xiang-wang-US/Cycloidal_Turret/Hardware/cycloidal_drive_12_1/12-1 Cycloidal Drive Assembly.STEP

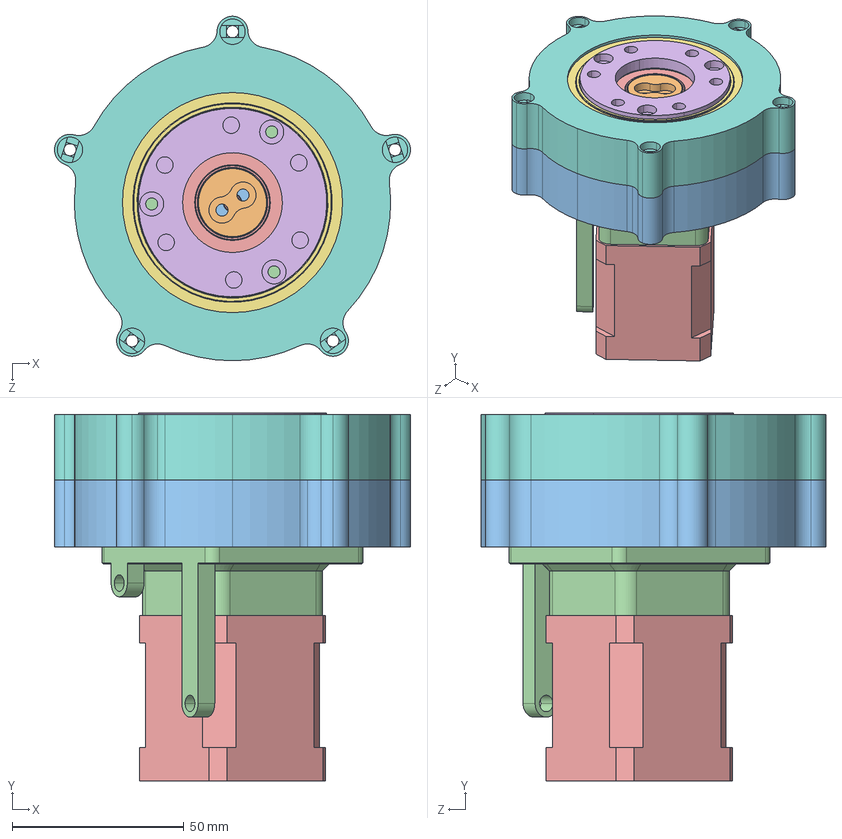
[picture p19: CAD file, 2026-10-12]
Hardware/cycloidal_drive_12_1/12-1 Cycloidal Drive Assembly.STEP
103.5 x 106.9 x 100.2 mm
Rotor Shaft
Rotor B
Rotor A
20x32x7 Bearing Ball x 4
Output B
55x72x9mm Bearing Ball
Housing B
Output A
M5x35 Dowel Pins x 3
Housing A
Nema17 Motor Adapter
42-48 Nema17 Stepper Motor
