xiang-wang-US/Cycloidal_Turret/Hardware/cycloidal_drive_18_1/18-1 Cycloidal Drive Assembly.STEP

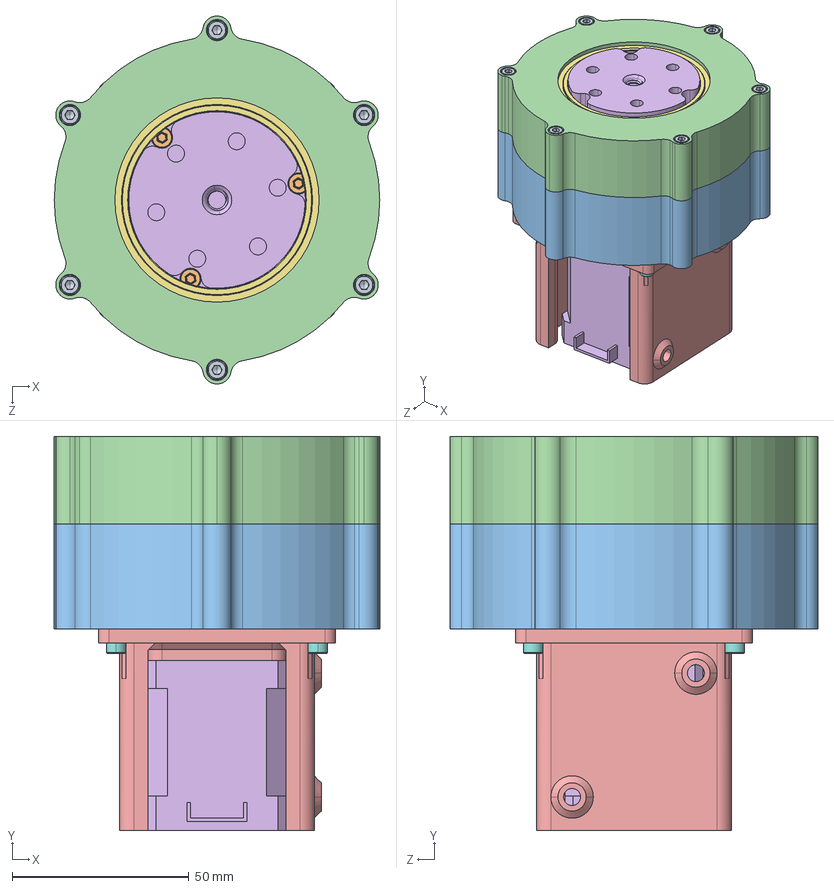
[picture p20: CAD file, 2026-10-12]
Hardware/cycloidal_drive_18_1/18-1 Cycloidal Drive Assembly.STEP
92.0 x 111.4 x 104.0 mm
Rotor Shaft Var1
20x32x7 Bearing Ball x 4
Output B Var1
50x65x7mm Ball Bearing x 2
Output A Var1
M5x30 Dowel Pin x 3
M3x25 Bolt [Simple] x 5
Housing A Var1
Housing B Var1
Nema17 Motor Adapter Var1
42-48 Nema17 Stepper Motor
Rotor B Var1
Rotor A Var1
socket head cap screw_am_B18.3.1M - 3 x 0.5 x 8 Hex SHCS -- 8NHX x 8
socket head cap screw_am_B18.3.1M - 3 x 0.5 x 25 Hex SHCS -- 18NHX x 6
