xiang-wang-US/Cycloidal_Turret/docs/Turret_Design_Journal.pdf

# Turret Main Doc

## Summer 2025

# Brainstorming

## - 2 axis - Gas or Spring for foam darts - Motors? Steppers or BLDC - Controls? ESP32 or Raspberry Pi

- Does base motor spin the top or itself.
- Gas, Stepper, ESP32, coupled.
- Gas and stepper because cheap and easy.
- ESP 32 because cheap.

## - Itself because we wanted 360 without wire tangling

# First Prototype

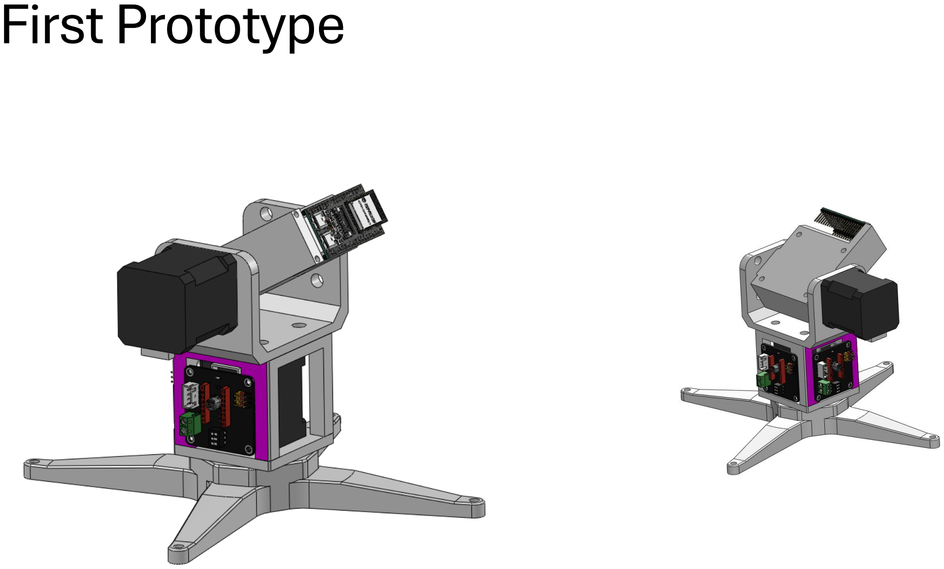
[picture p21: page 3]

Spins freely.

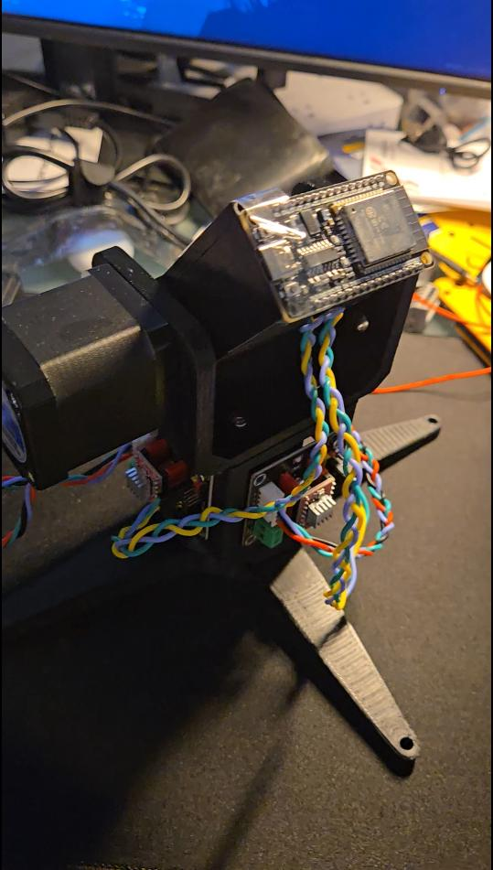
[picture p22: figure]

But the whole top part was very heavily and the motor could not move it.

# Issues

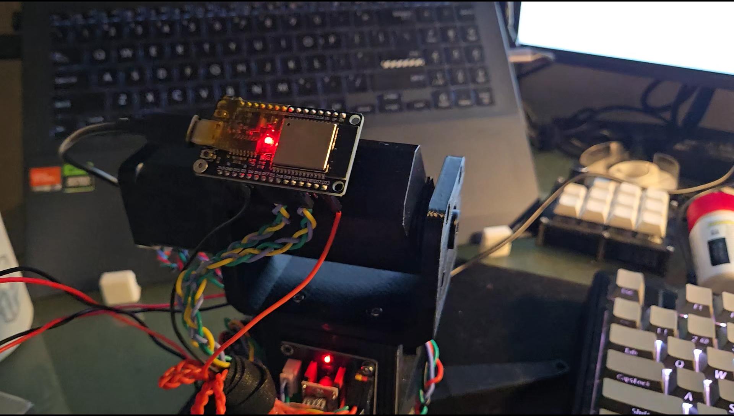
[picture p23: figure]

But the whole top part
was very heavily and
the bottom motor
could not move it.

# Use cycloidal gear reduction?

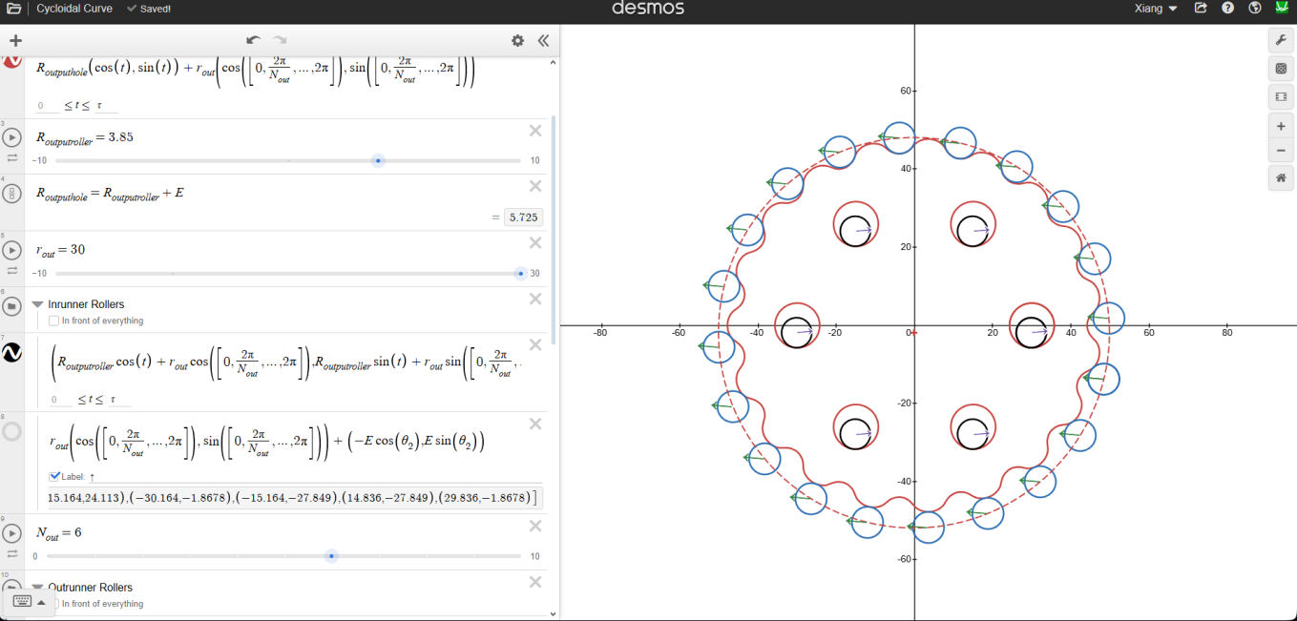
[picture p24: figure]

https://www.desmos.com/calculator/neoglqbxig

Benefits
- Quiet
- Very compact

# Curve in SolidWorks

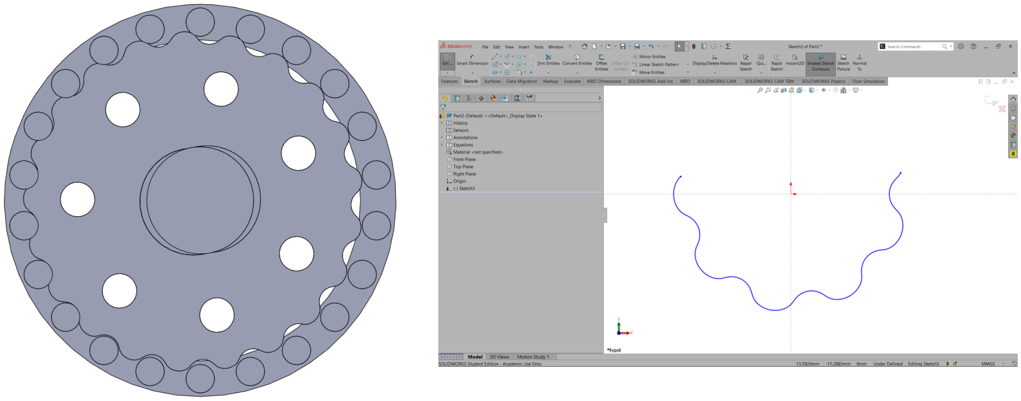
[picture p25: figure]

# Stepper with reducer

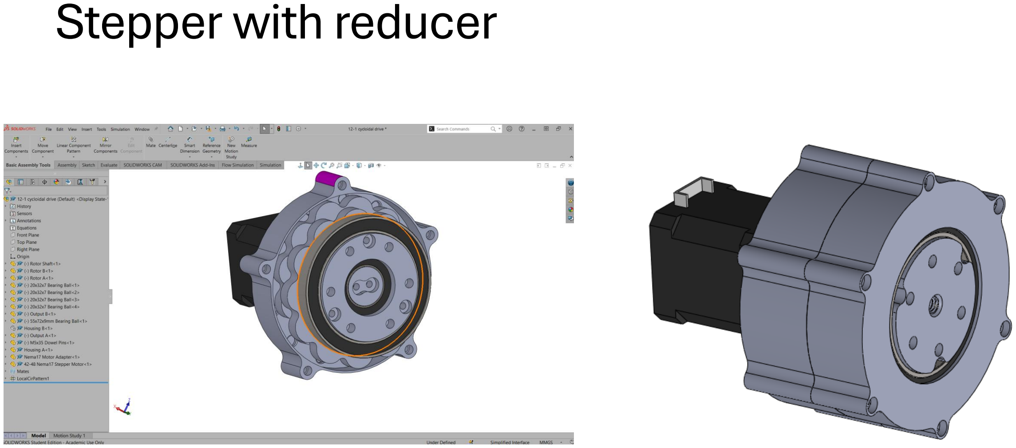
[picture p26: page 8]

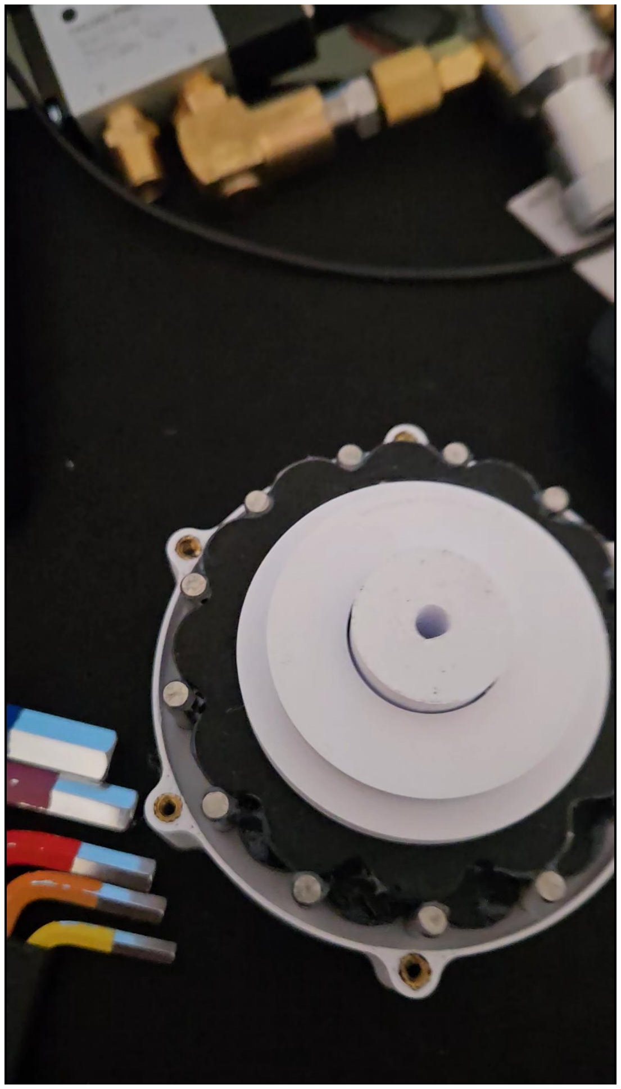
[picture p27: figure]

# Real life validation

# Two perpendiculars sets?

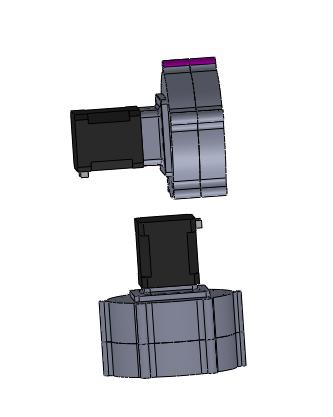
[picture p28: figure]

# Design all the mating brackets

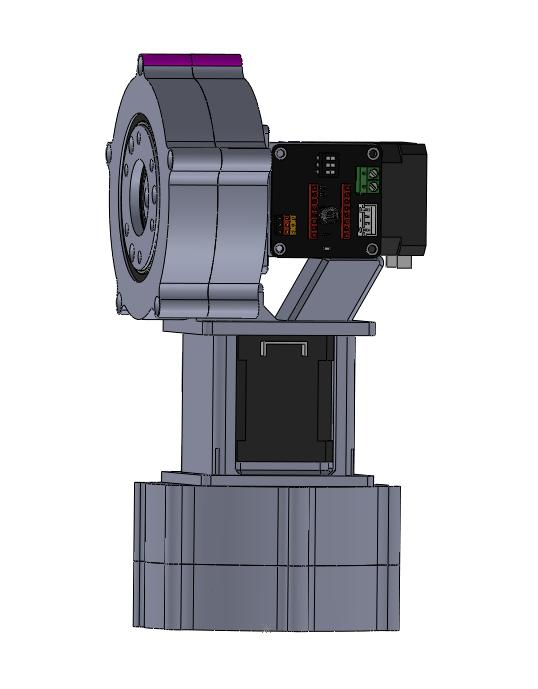
[picture p29: figure]

# Designing gas system

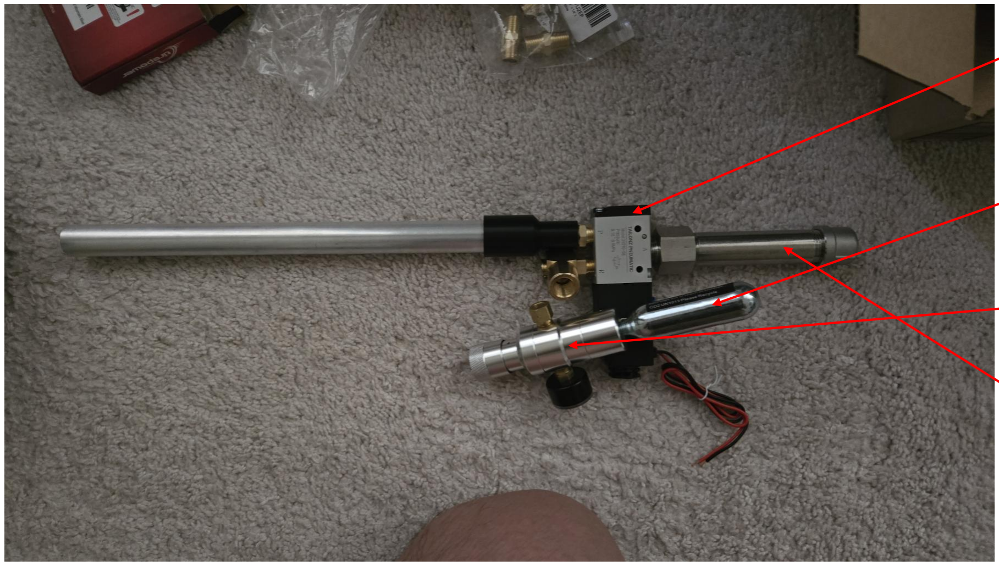
[picture p30: figure]

3 way solenoid
valve

CO2
cartridge

Regulator

Pressure chamber
for cycling shots

# Issue

- Solenoid is not cycling with 12 volts.

## - Increasing voltage does nothing - You can hear it click - People on Amazon say its broken

- Manually cycling it works only along one set of valves.
- Oh you need the increase the pressure going to unstick the valve. It doesn’t work below 20 psi.

# Figuring out why the solenoid didn’t work

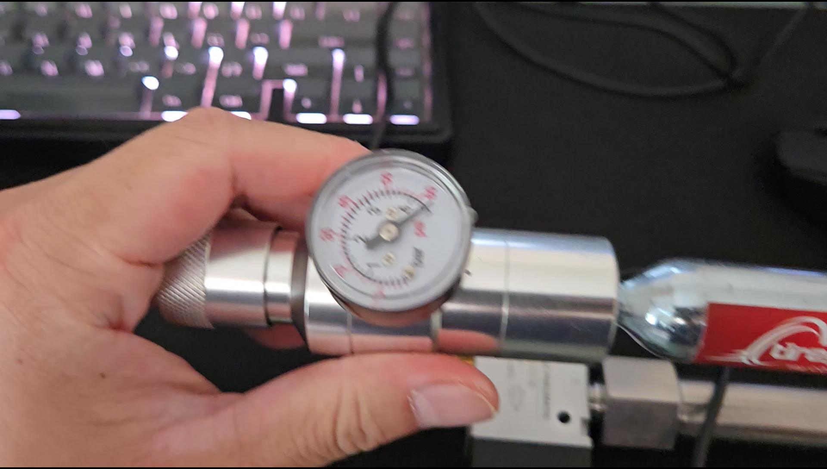
[picture p31: figure]

# Quick firing test

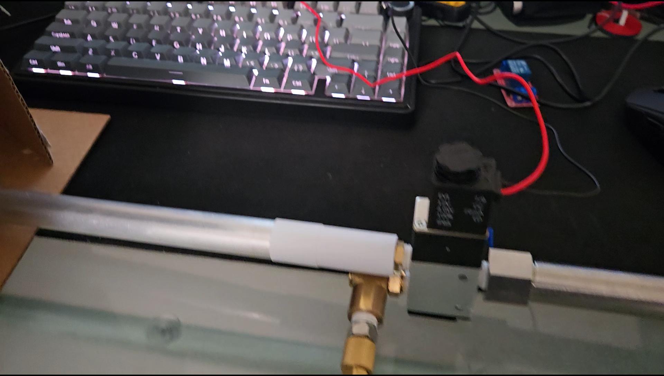
[picture p32: figure]

# Scary!

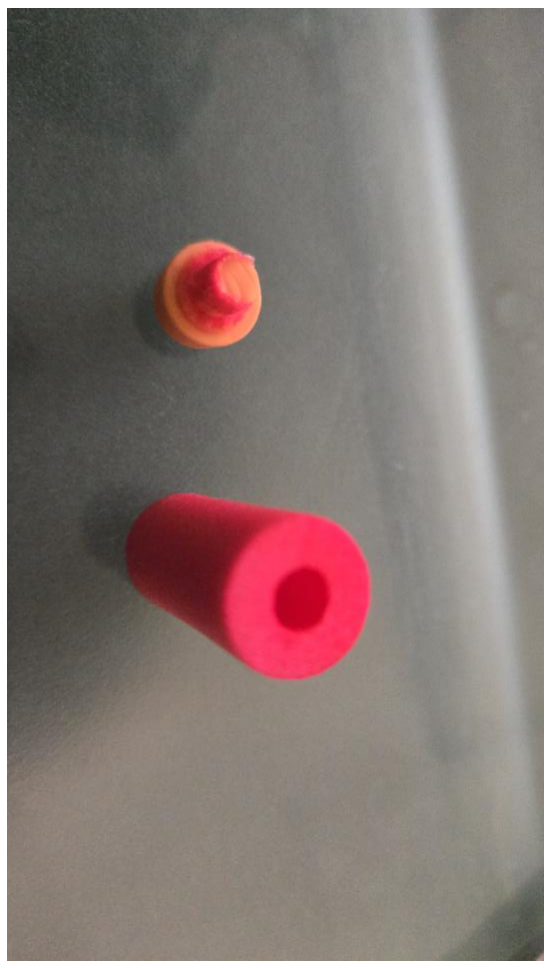
[picture p33: figure]

It broke the dart

Optimizing Pressure and Length | Legend

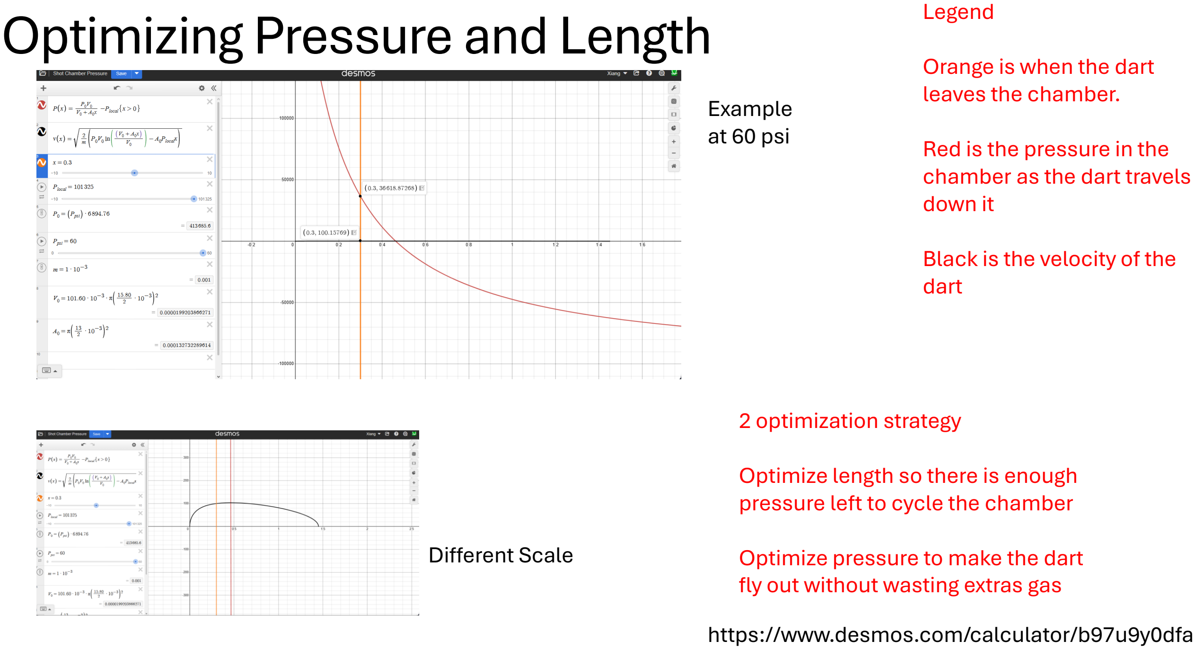
[picture p34: page 17]

Orange is when the dart
leaves the chamber.

Red is the pressure in the chamber as the dart travels down it

Black is the velocity of the dart

2 optimization strategy

Optimize length so there is enough pressure left to cycle the chamber

Optimize pressure to make the dart
fly out without wasting extras gas

Different Scale

https://www.desmos.com/calculator/b97u9y0dfa

Example
at 60 psi

# Optimizing Pressure and Length

Caution with the previous
calculation.

It does not account for
friction so add a little bit extra pressure to
overcome it.

# Putting it into CAD

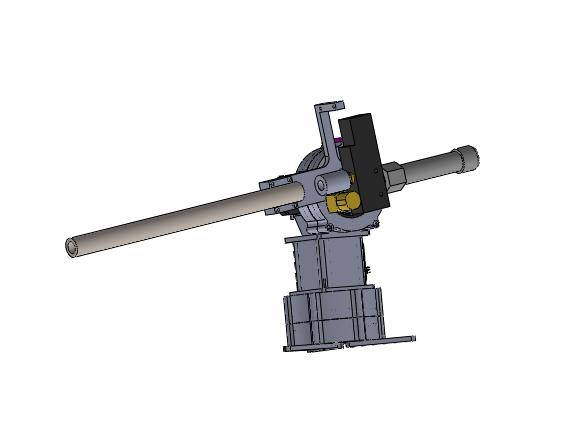
[picture p35: figure]

# Figuring out ESP32 pins

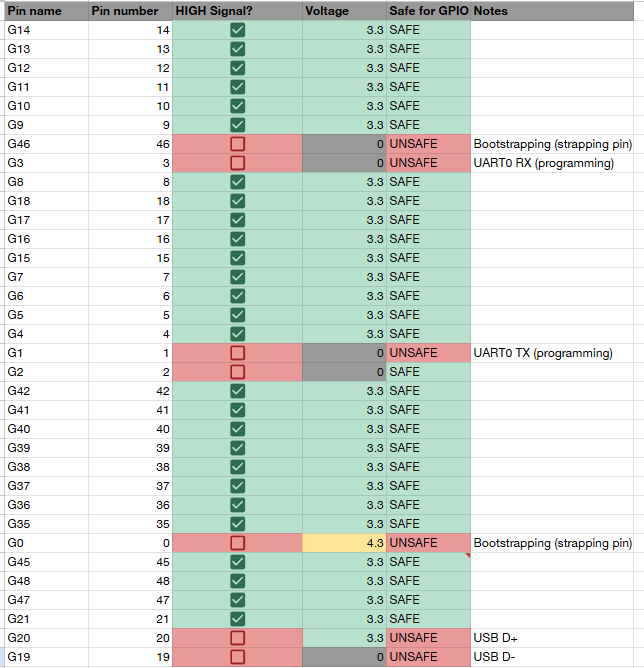
[picture p36: figure]

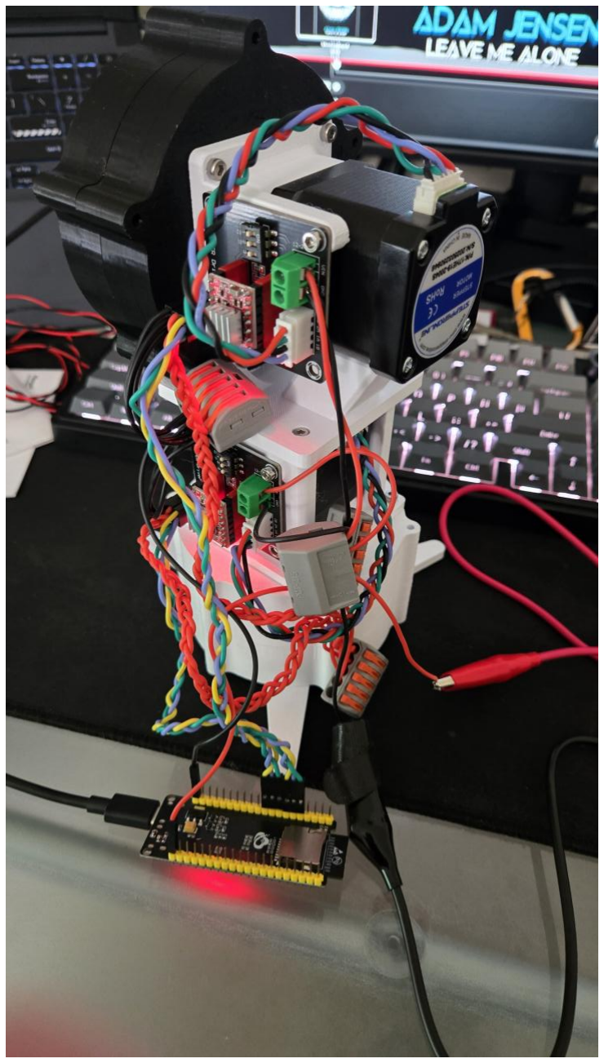
[picture p37: figure]

# Doing the wiring

# Look at it go!

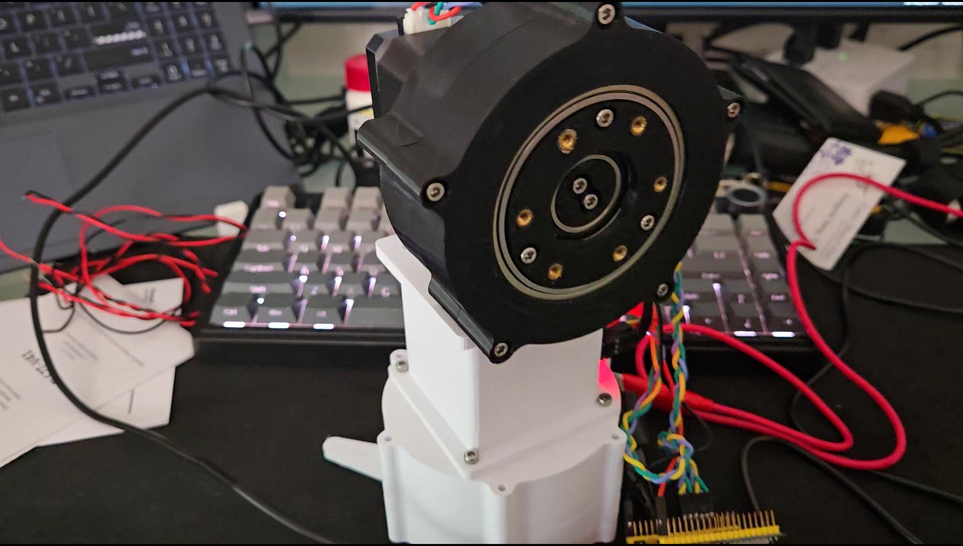
[picture p38: figure]

# More wiring

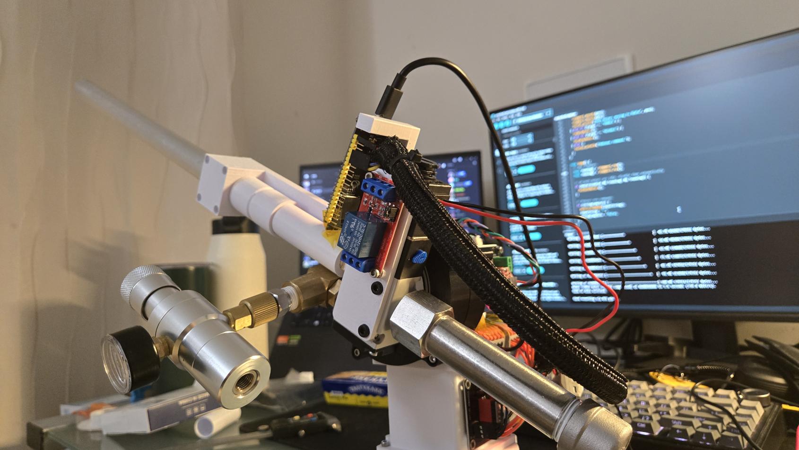
[picture p39: figure]

# Quick Motion Test

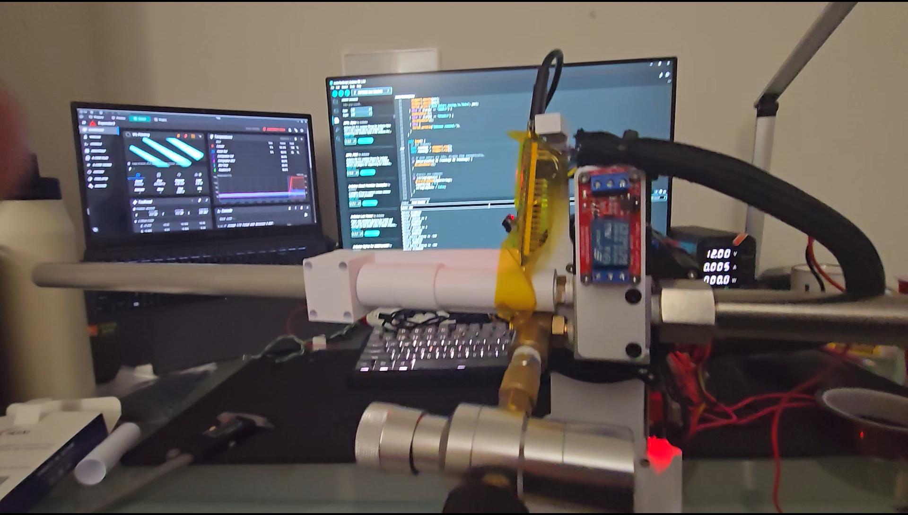
[picture p40: figure]

Choppy sound from bad
motor drive connection

# Motion and fire sequence

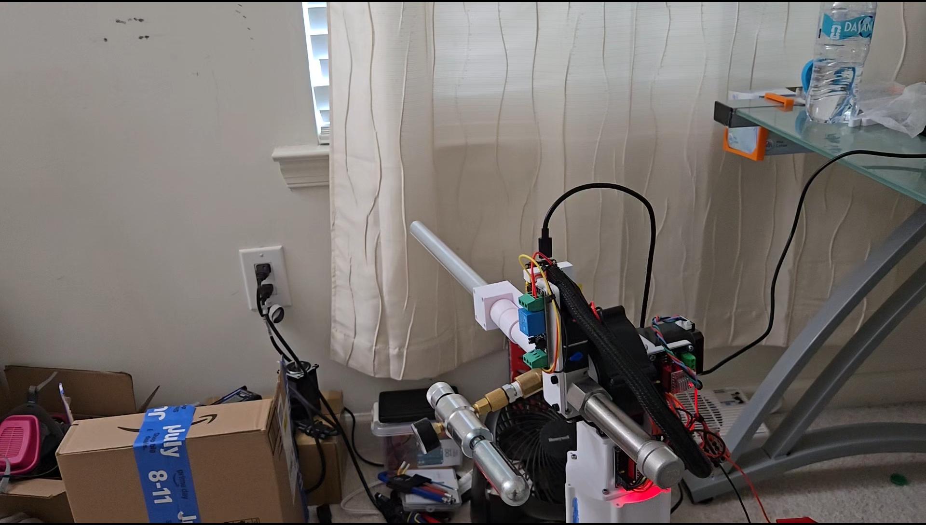
[picture p41: figure]

Gas turned off
to save CO2
cartridges.

See solenoid
LED light up

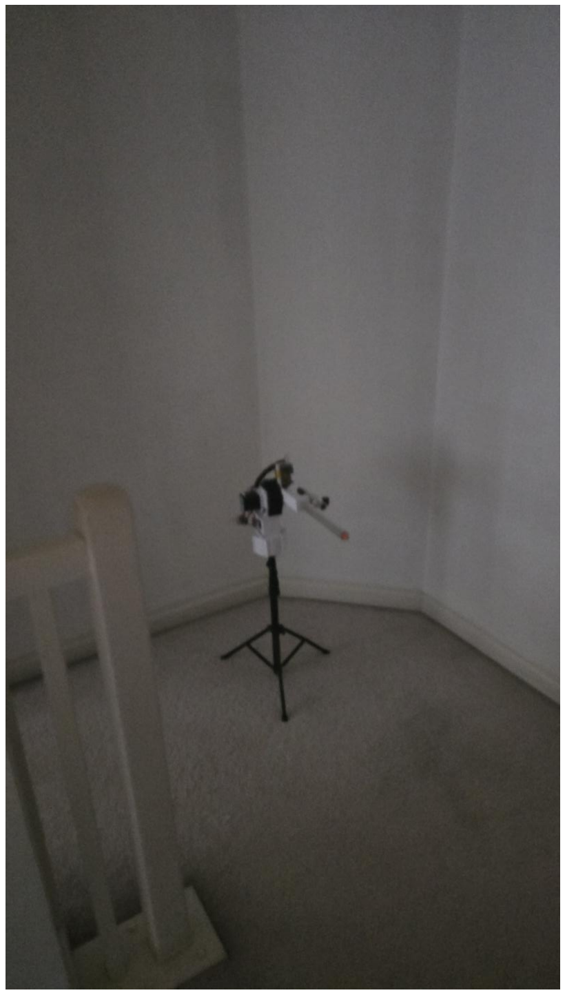
[picture p42: figure]

# Turret in my hallway!

# Computer Vision and Tracking Work

## - Worked in collaboration with Jinson Jimmy (UMD Student) - Developed a system capable of identifying human features

ESP32 Camera | Local Computer

Network Communication

- Handles Motion
Control
- Handles Firing
Sequence
- Handles Pictures
- Handles
identifying human
feature from
camera
- Handles
calculating
motion trajectory

# Issues

## - The ESP32 was very slow at getting the image and sending it over network - ESP32 had issues with running facial recognition locally - ESP32 camera resolution wasn’t the best

# End of Project

## - Future works

- Add a battery so the system could be independent of a power supply.

## - Possibly acquire a faster microcontroller or even upgrade to an SBC to do local computation - Add automatic dart cycling
